edenbarby/reflow-oven/README.md

# reflow-oven
A DIY reflow oven with a little inspiration from the internet.
