edenbarby/reflow-oven/hardware/reflow-oven-overlay-bottom.pdf

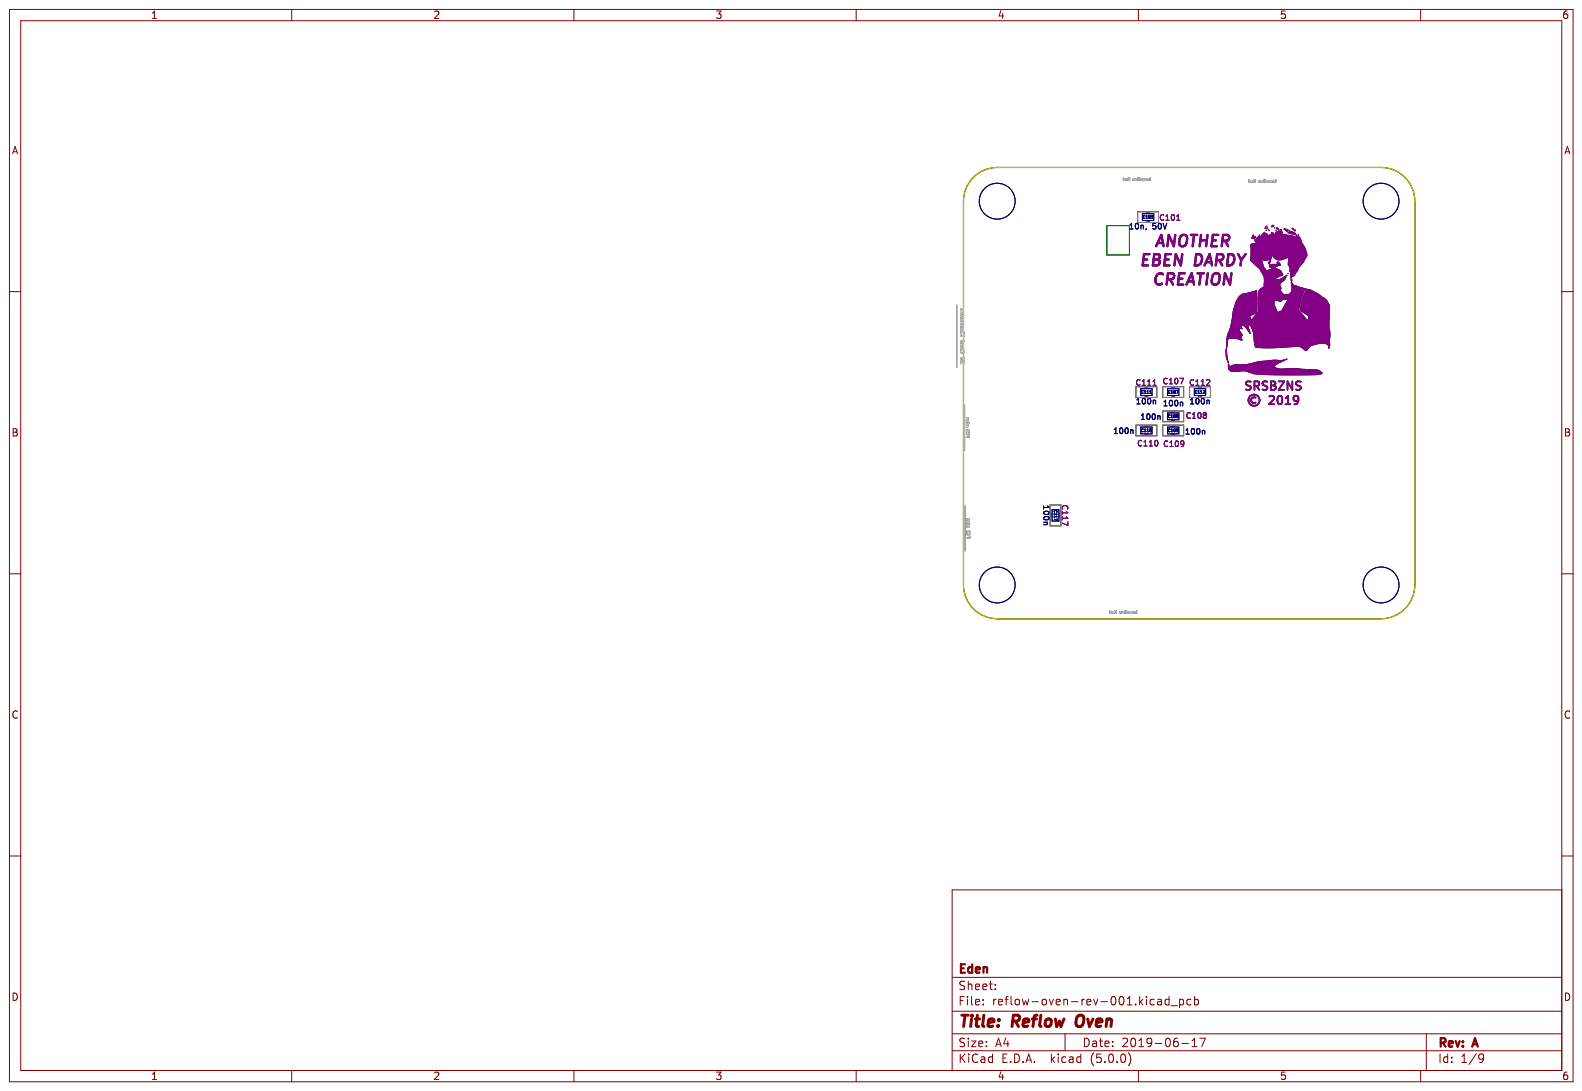
[picture p1: page 1]
