edenbarby/reflow-oven/hardware/reflow-oven-overlay-top.pdf

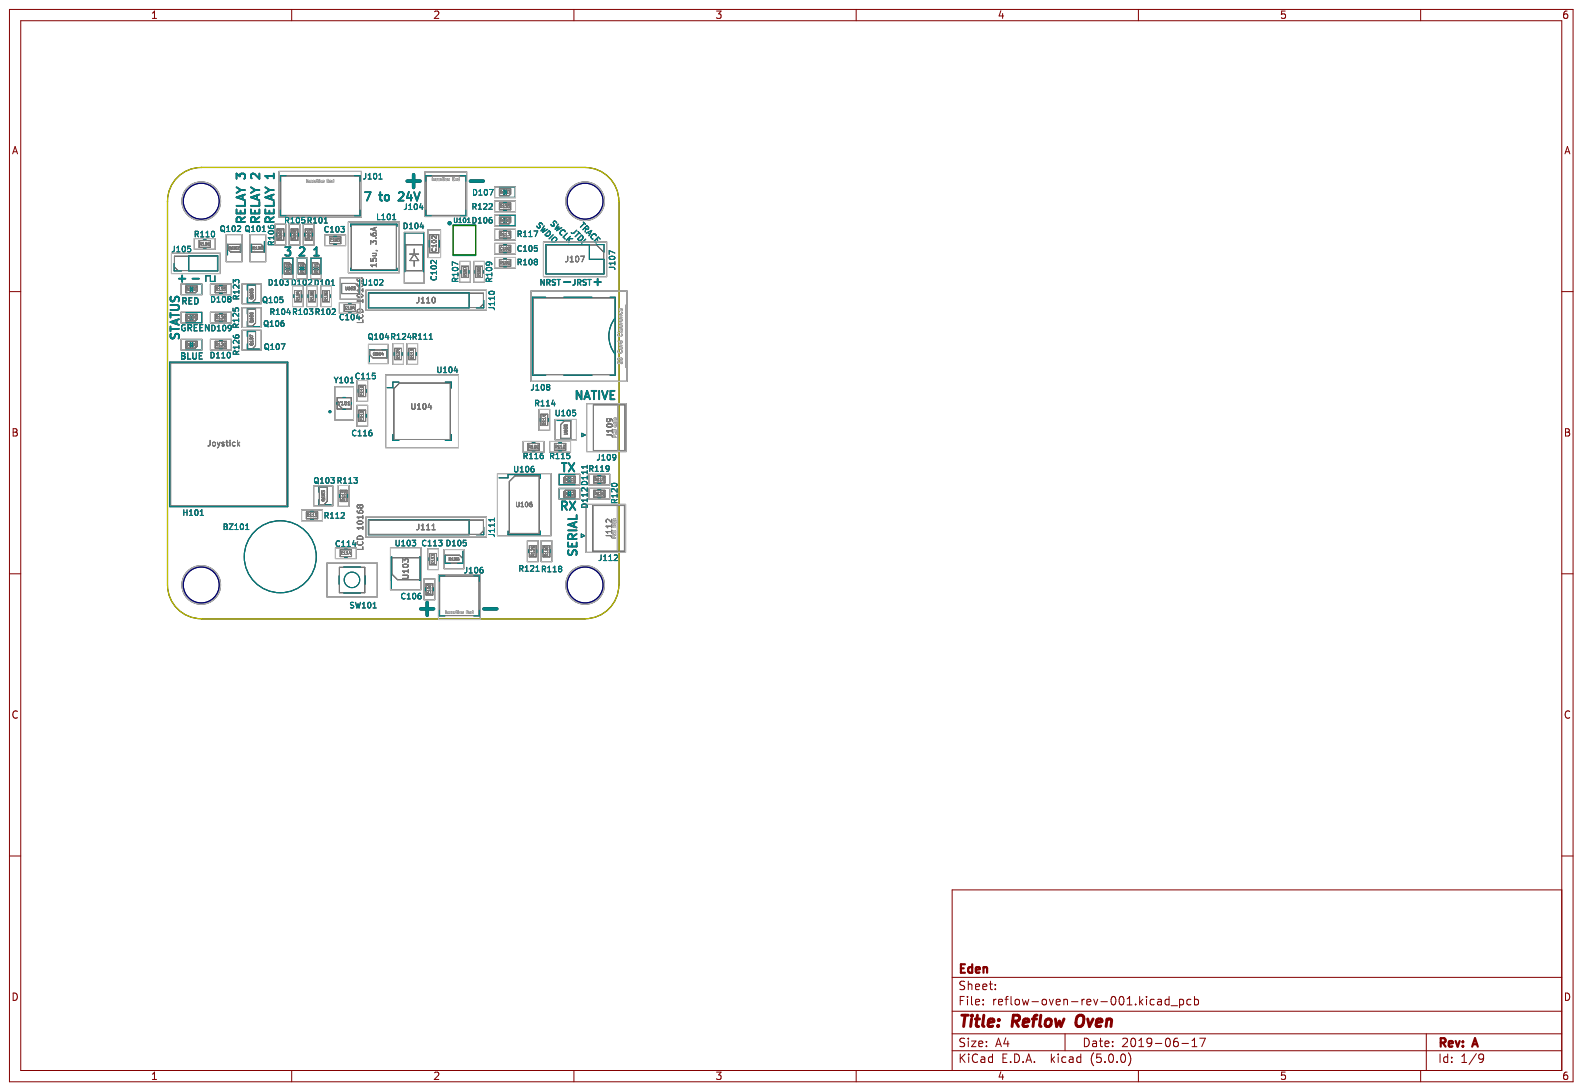
[picture p2: page 1]
