edenbarby/reflow-oven/hardware/reflow-oven-schematic.pdf

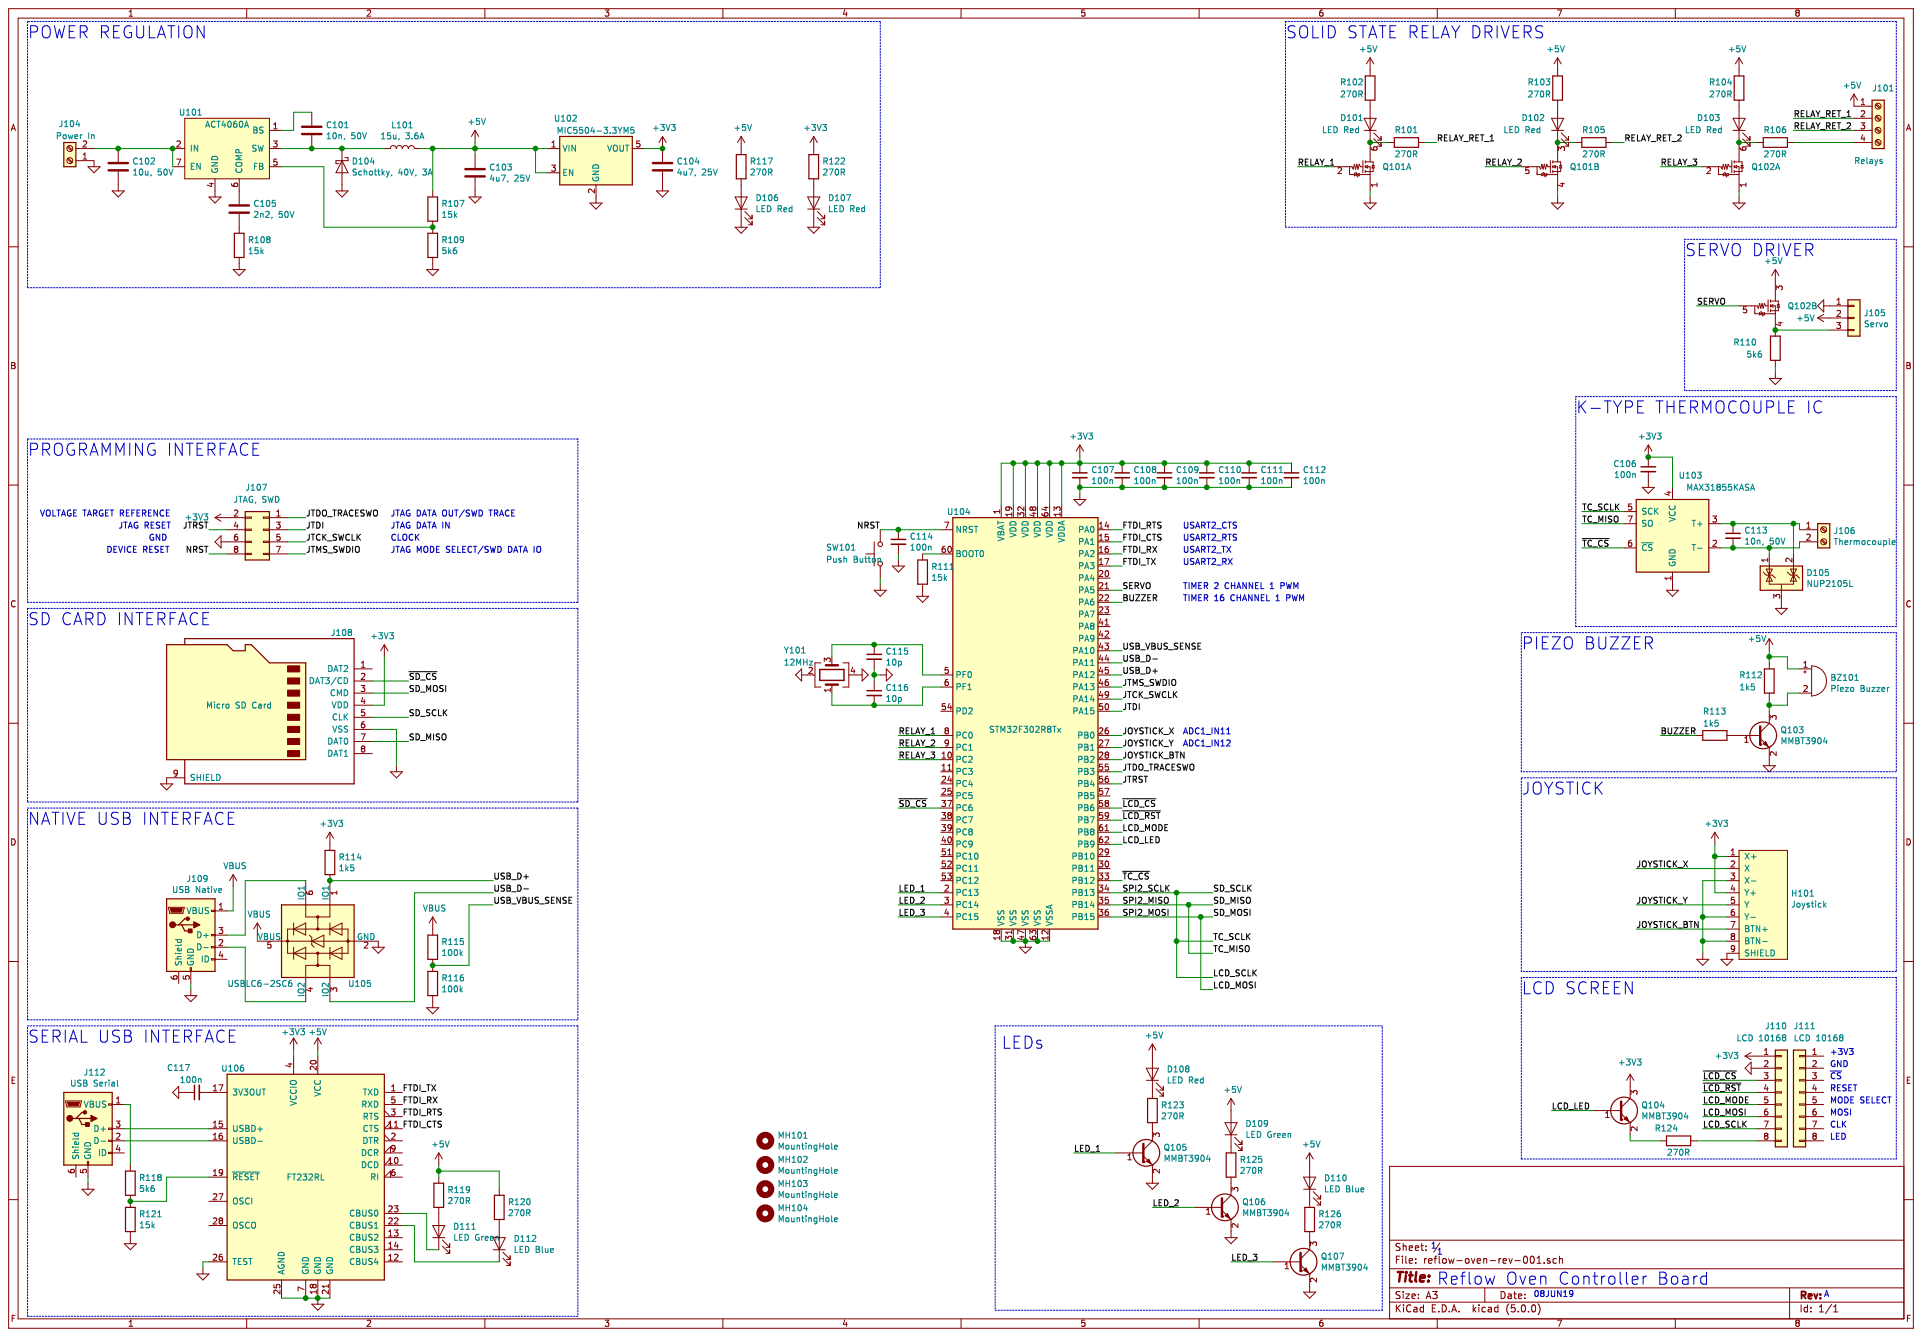
[picture p3: page 1]
