edenbarby/reflow-oven/hardware/reflow-oven-rev-001.kicad_pcb

## KiCad design hardware/reflow-oven-rev-001.kicad_pcb (2020-06-08)

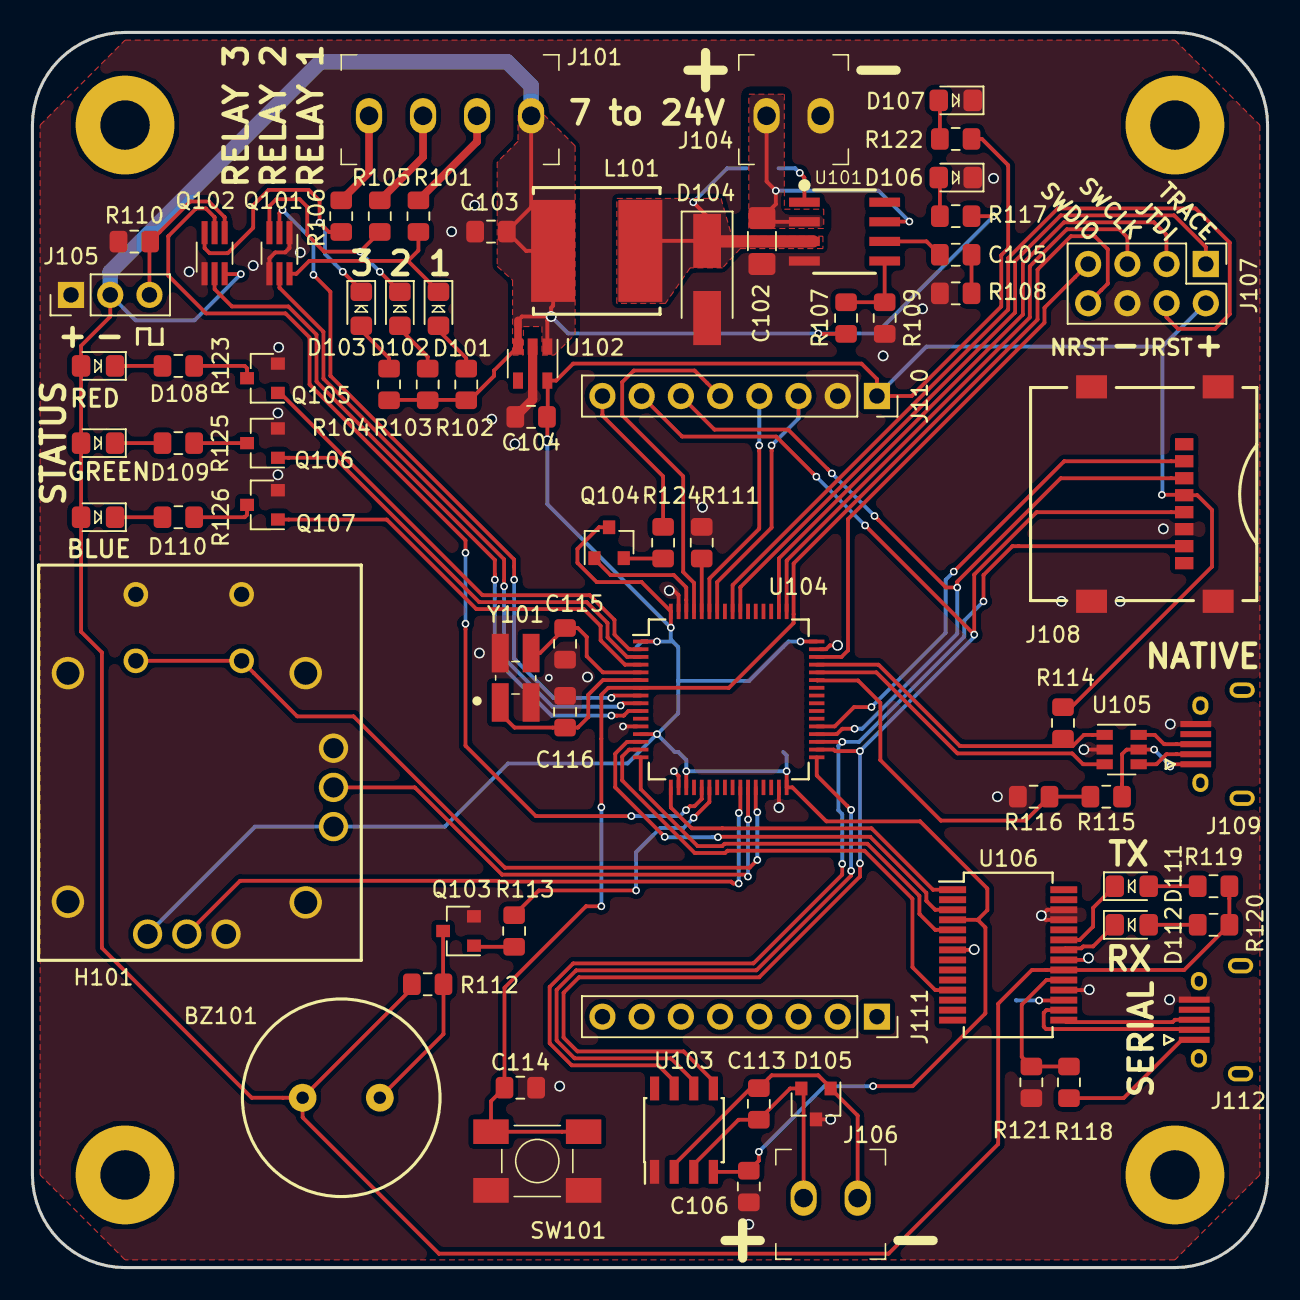
[picture p4: board reflow-oven-rev-001.kicad_pcb from above]

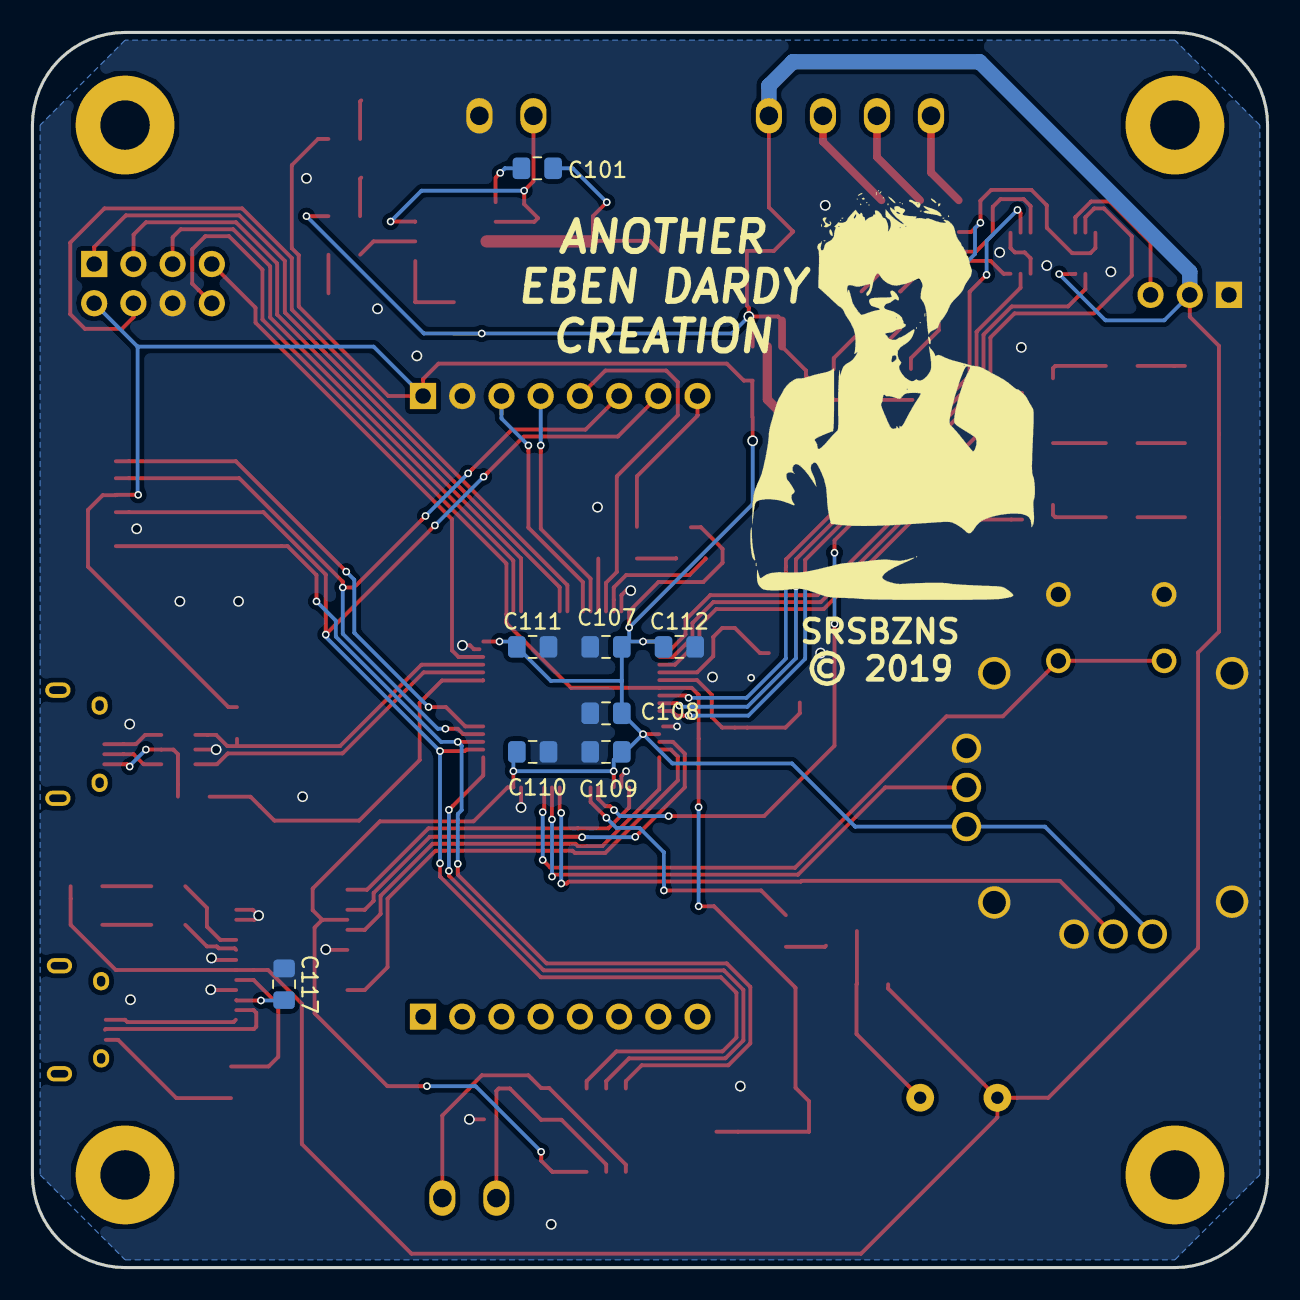
[picture p5: board reflow-oven-rev-001.kicad_pcb from below]

Board: 2 copper layers, 80.0 x 80.0 mm, 87 parts (8 on the bottom side), 81 nets.

Parts:
BZ101: Piezo Buzzer; PKM13EPYH4000-A0
C101, C113: 10n, 50V; C_0805_2012Metric_Pad1.15x1.40mm_HandSolder
C102: 10u, 50V; C_1206_3216Metric_Pad1.42x1.75mm_HandSolder
C103, C104: 4u7, 25V; C_0805_2012Metric_Pad1.15x1.40mm_HandSolder
C105: 2n2, 50V; C_0805_2012Metric_Pad1.15x1.40mm_HandSolder
C106, C107, C108, C109, C110, C111, C112, C114, C117: 100n; C_0805_2012Metric_Pad1.15x1.40mm_HandSolder
C115, C116: 10p; C_0805_2012Metric_Pad1.15x1.40mm_HandSolder
D101, D102, D103, D106, D107, D108: LED Red; LED_0805_2012Metric_Pad1.15x1.40mm_HandSolder
D104: Schottky, 40V, 3A; D_SMA_Handsoldering
D105: NUP2105L; SOT-23
D109, D111: LED Green; LED_0805_2012Metric_Pad1.15x1.40mm_HandSolder
D110, D112: LED Blue; LED_0805_2012Metric_Pad1.15x1.40mm_HandSolder
H101: Joystick; COM-09032
J101: Relays; Connector_Pheonix_WTB_Screw_3.5mm_4X1
J104: Power In; Connector_Pheonix_WTB_Screw_3.5mm_2X1
J105: Servo; PinHeader_1x03_P2.54mm_Vertical
J106: Thermocouple; Connector_Pheonix_WTB_Screw_3.5mm_2X1
J107: JTAG, SWD; PinHeader_2x04_P2.54mm_Vertical
J108: Micro SD Card; MEM2067-02-180-00-A
J109: USB Native; USB_Micro-B_Amphenol_10118194-0X0XLF
J110, J111: LCD 10168; PinSocket_1x08_P2.54mm_Vertical
J112: USB Serial; USB_Micro-B_Amphenol_10118194-0X0XLF
L101: 15u, 3.6A; SRN8040TA-150M
MH101, MH102, MH103, MH104: MountingHole; MountingHole_3.2mm_M3_Pad
Q101, Q102: SSM6N7002KFU; SOT-363_SC-70-6_Handsoldering
Q103, Q104, Q105, Q106, Q107: MMBT3904; SOT-23
R101, R102, R103, R104, R105, R106, R117, R119, R120, R122, R123, R124, R125, R126: 270R; R_0805_2012Metric_Pad1.15x1.40mm_HandSolder
R107, R108, R111, R121: 15k; R_0805_2012Metric_Pad1.15x1.40mm_HandSolder
R109, R110, R118: 5k6; R_0805_2012Metric_Pad1.15x1.40mm_HandSolder
R112, R113, R114: 1k5; R_0805_2012Metric_Pad1.15x1.40mm_HandSolder
R115, R116: 100k; R_0805_2012Metric_Pad1.15x1.40mm_HandSolder
SW101: Push Button; SW_SPST_CK_PTS647_4.5mm
U101: ACT4060A
U102: MIC5504-3.3YM5; SOT-23-5
U103: MAX31855KASA; SOIC-8_3.9x4.9mm_P1.27mm
U104: STM32F302R8Tx; LQFP-64_10x10mm_P0.5mm
U105: USBLC6-2SC6; SOT-23-6
U106: FT232RL; SSOP-28_5.3x10.2mm_P0.65mm
Y101: 12MHz; Crystal_SMD_2520-4Pin_2.5x2.0mm_HandSoldering

Connections:
+3V3: C104.1, C106.1, C107.1, C108.1, C109.1, C110.1, C111.1, C112.1, H101.1, H101.4, J107.2, J108.4, J110.1, Q104.3, R114.1, R122.1, U102.5, U103.4, U104.1, U104.13, U104.19, U104.32, U104.48, U104.64, U106.4
+5V: BZ101.1, C103.1, D108.2, D109.2, D110.2, J101.1, J105.2, L101.2, Q102.3, R102.1, R103.1, R104.1, R107.1, R112.1, R117.1, R119.1, R120.1, U102.1, U102.3, U106.20
/BUZZER: R113.2, U104.22
/FTDI_CTS: U104.15, U106.11
/FTDI_RTS: U104.14, U106.3
/FTDI_RX: U104.16, U106.5
/FTDI_TX: U104.17, U106.1
/JOYSTICK_BTN: H101.7, U104.28
/JOYSTICK_X: H101.2, U104.26
/JOYSTICK_Y: H101.5, U104.27
/JTCK_SWCLK: J107.5, U104.49
/JTDI: J107.3, U104.50
/JTDO_TRACESWO: J107.1, U104.55
/JTMS_SWDIO: J107.7, U104.46
/JTRST: J107.4, U104.56
/LCD_LED: Q104.1, U104.62
/LCD_MODE: J110.5, U104.61
/LCD_MOSI: J108.3, J110.6, U104.36
/LCD_SCLK: J108.5, J110.7, U103.5, U104.34
/LED_1: Q105.1, U104.2
/LED_2: Q106.1, U104.3
/LED_3: Q107.1, U104.4
/NRST: C114.1, J107.8, SW101.2, U104.7
/RELAY_1: Q101.2, U104.8
/RELAY_2: Q101.5, U104.9
/RELAY_3: Q102.2, U104.10
/RELAY_RET_1: J101.2, R101.2
/RELAY_RET_2: J101.3, R105.2
/SD_MISO: J108.7, U103.7, U104.35
/SERVO: Q102.5, U104.21
/USB_D+: R114.2, U104.45, U105.1
/USB_D-: U104.44, U105.3
/USB_VBUS_SENSE: R115.2, R116.1, U104.43
/~LCD_CS: J110.3, U104.58
/~LCD_RST: J110.4, U104.59
/~SD_CS: J108.2, U104.37
/~TC_CS: U103.6, U104.33
GND: C102.2, C103.2, C104.2, C106.2, C107.2, C108.2, C109.2, C110.2, C111.2, C112.2, C114.2, C115.2, C116.1, C117.1, D104.2, D105.3, D106.1, D107.1, H101.3, H101.6, H101.8, H101.9, J104.1, J105.1, J107.6, J108.6, J108.9, J109.5, J110.2, J112.5, Q101.1, Q101.4, Q102.1, Q103.2, Q105.2, Q106.2, Q107.2, R108.2, R109.2, R110.2, R111.2, R116.2, R121.2, SW101.1, U101.4, U102.2, U103.1, U104.12, U104.18, U104.31, U104.47, U104.63, U105.2, U106.7, U106.18, U106.21, U106.25, U106.26, Y101.2, Y101.4
unnamed: BZ101.2, Q103.3, R112.2
unnamed: C101.1, U101.1
unnamed: C101.2, D104.1, L101.1, U101.3
unnamed: C102.1, J104.2, U101.2, U101.7
unnamed: C105.1, U101.6
unnamed: C105.2, R108.1
unnamed: C113.1, D105.2, J106.1, U103.3
unnamed: C113.2, D105.1, J106.2, U103.2
unnamed: C115.1, U104.5, Y101.3
unnamed: C116.2, U104.6, Y101.1
unnamed: C117.2, U106.17
unnamed: D101.1, Q101.6, R101.1
unnamed: D101.2, R102.2
unnamed: D102.1, Q101.3, R105.1
unnamed: D102.2, R103.2
unnamed: D103.1, Q102.6, R106.1
unnamed: D103.2, R104.2
unnamed: D106.2, R117.2
unnamed: D107.2, R122.2
unnamed: D108.1, R123.1
unnamed: D109.1, R125.1
unnamed: D110.1, R126.1
unnamed: D111.1, U106.23
unnamed: D111.2, R119.2
unnamed: D112.1, U106.22
unnamed: D112.2, R120.2
unnamed: J101.4, R106.2
unnamed: J105.3, Q102.4, R110.1
unnamed: J109.2, U105.4
unnamed: J109.3, U105.6
unnamed: J110.8, R124.2
unnamed: J112.1, R118.1
unnamed: J112.2, U106.16
unnamed: J112.3, U106.15
unnamed: Q103.1, R113.1
unnamed: Q104.2, R124.1
unnamed: Q105.3, R123.2
unnamed: Q106.3, R125.2
unnamed: Q107.3, R126.2
unnamed: R107.2, R109.1, U101.5
unnamed: R111.1, U104.60
unnamed: R118.2, R121.1, U106.19
VBUS: J109.1, R115.1, U105.5
