edenbarby/reflow-oven/(commit log)

2020-06-08 Hardware designs are complete and fabricated (mostly). Software started, LCD drivers fairly fuctional at the moment.
    [2019-07-14T061030.csv, reflow-oven-bom.csv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]
2020-06-26 Added SPI2 and LCD drivers (they are mostly functional), added additional warning flags to build system.
2020-06-26 Added basic polling USART2 drivers. Will eventually migrate them to interrupt driven but this will do for the time being.
2020-07-04 Expanded spi driver to handle multiple users with different settings. Added thermocouple drivers. Disabled overrun detection on USART because it seems to block reception of terminal input if there is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
2020-07-16 Modified usart2 drivers so that they're now interrupt driven with an internal ring buffer for rx and tx (also added a ring buffer module). Added a consistent overhead byte stuffing module for furture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
2020-07-16 Adjusted code style. Added python script to help display expected LCD output using GDB dump of frame buffer.
2020-10-25 Added serial driver which leverages ring buffers for interrupt safe buffering and COBS for packet delineation. Adjusted max31855 driver to report temps in int16 so it's easier to pass over serial to 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
    [cobs.c, main.c, max31855.c, ring_buffer.h, serial.c, serial.h, status_led.h]
2020-10-25 Created simple app to interface with reflow oven from a PC, leveraging the tkinter and matplotlib library. The app is seperated into front/back-end with reflowoven.py handling comms to the oven direc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
    [reflow-profile-2.csv]
2021-02-01 Comms refactor, restructured program flow to utilise state machines more effectively.
2021-05-14 Simplified serial comms with between the app and oven, max31855 temp monitoring is now handled in the max31855_task which incorporates some smoothing, temperature control and reflow profile changed f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
    [reflow-profile-2.csv]
