edenbarby/reflow-oven/(notices)

Notices in the files:
hardware/reflow-oven-rev-001.kicad_pcb:
© 2019
